iustinG-afk/The48ErrCar/docs/images/1.jpg

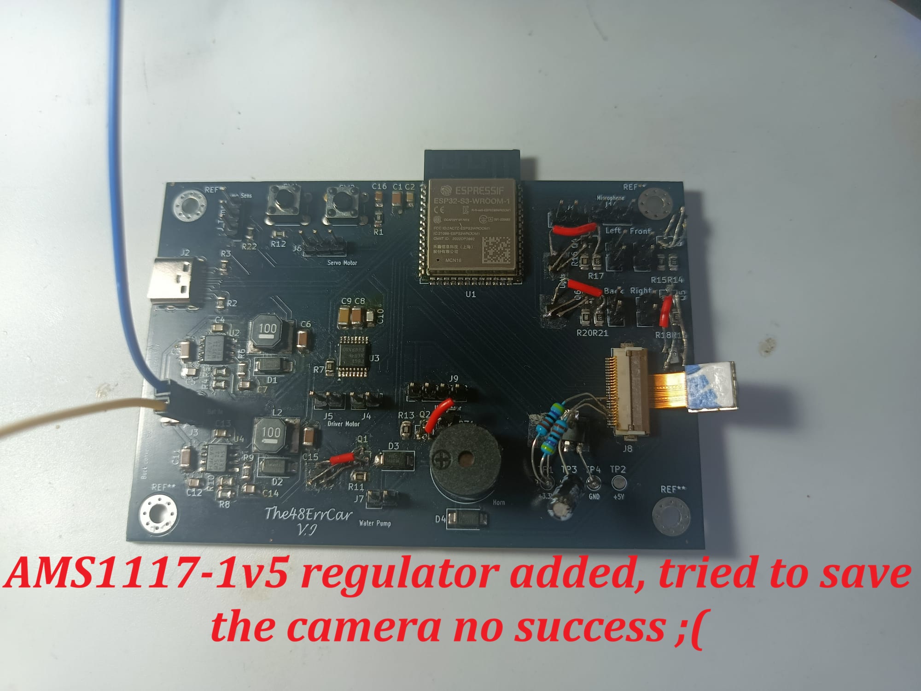
docs/images/1.jpg
