iustinG-afk/The48ErrCar/docs/images/3.jpg

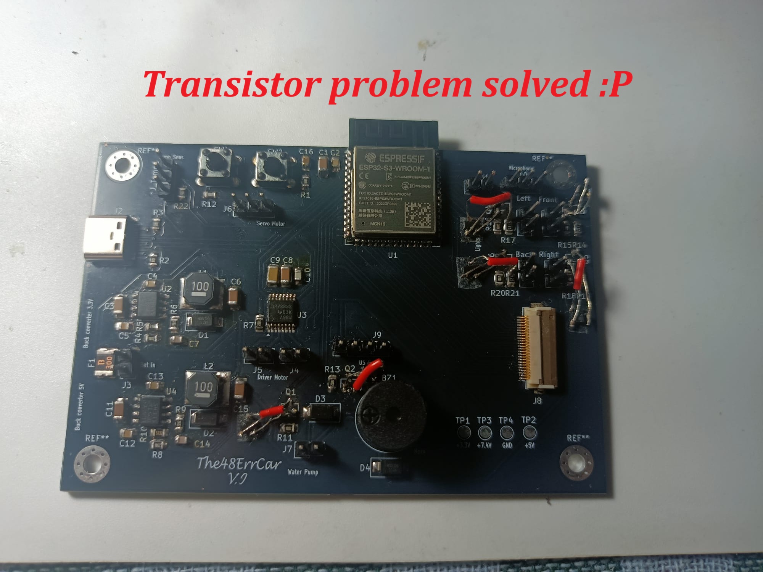
docs/images/3.jpg
