iustinG-afk/The48ErrCar/docs/images/4.jpg

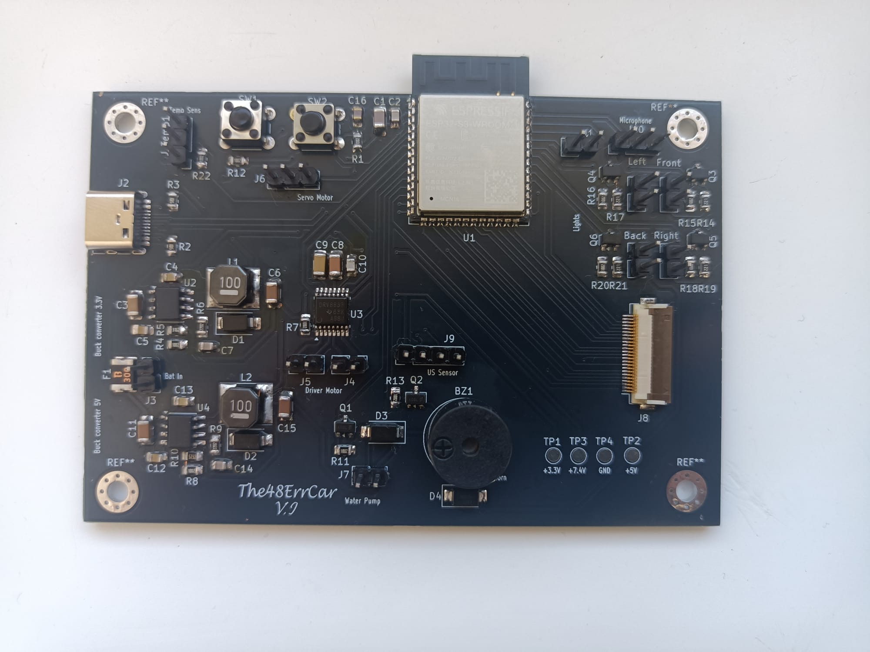
docs/images/4.jpg
