iustinG-afk/The48ErrCar/docs/images/5.jpg

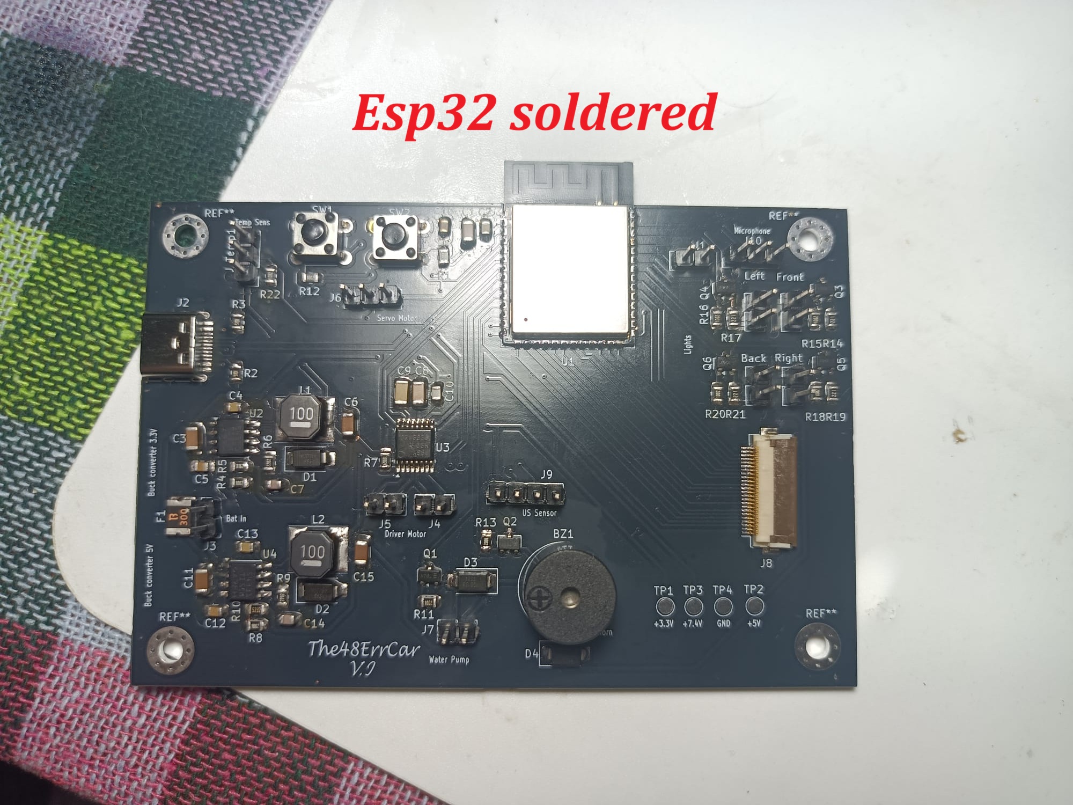
docs/images/5.jpg
