iustinG-afk/The48ErrCar/docs/images/6.jpg

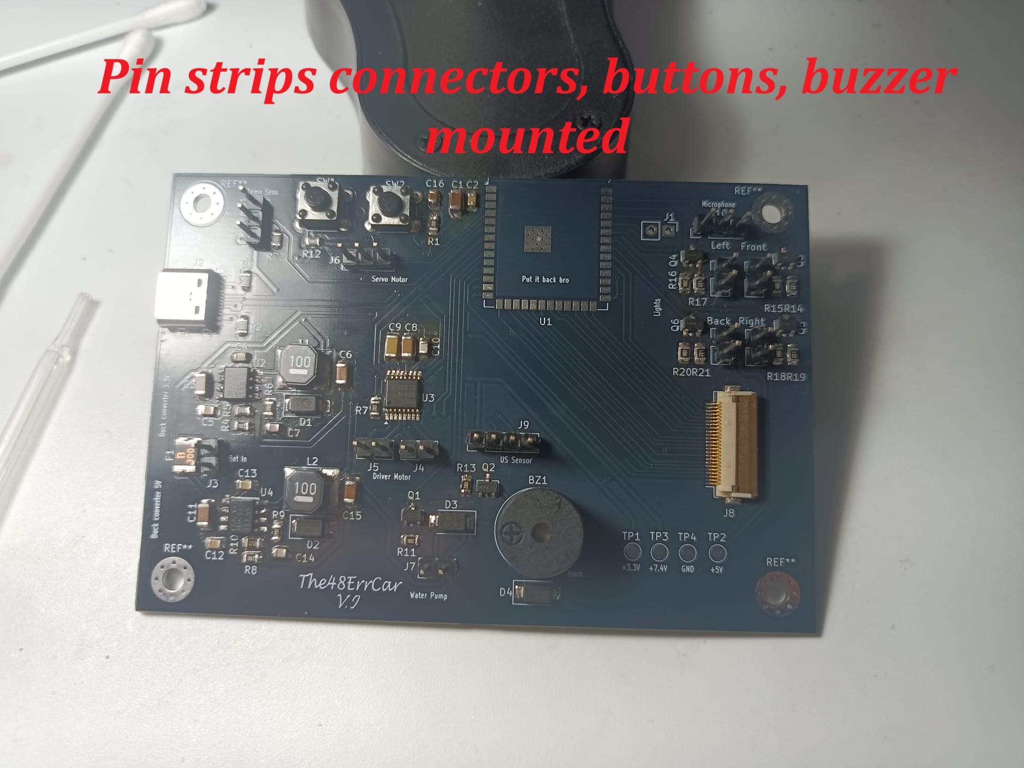
docs/images/6.jpg
