iustinG-afk/The48ErrCar/docs/images/7.jpg

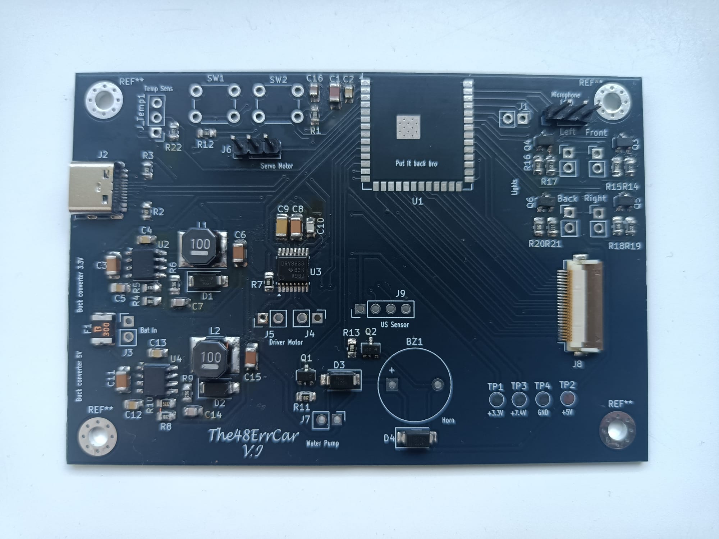
docs/images/7.jpg
