iustinG-afk/The48ErrCar/docs/images/8.jpg

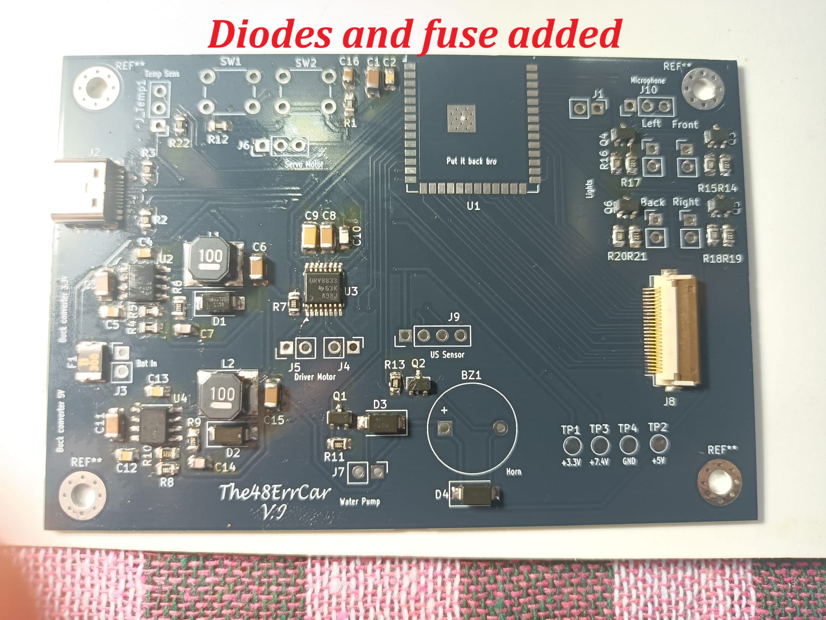
docs/images/8.jpg
