iustinG-afk/The48ErrCar/docs/images/9.jpg

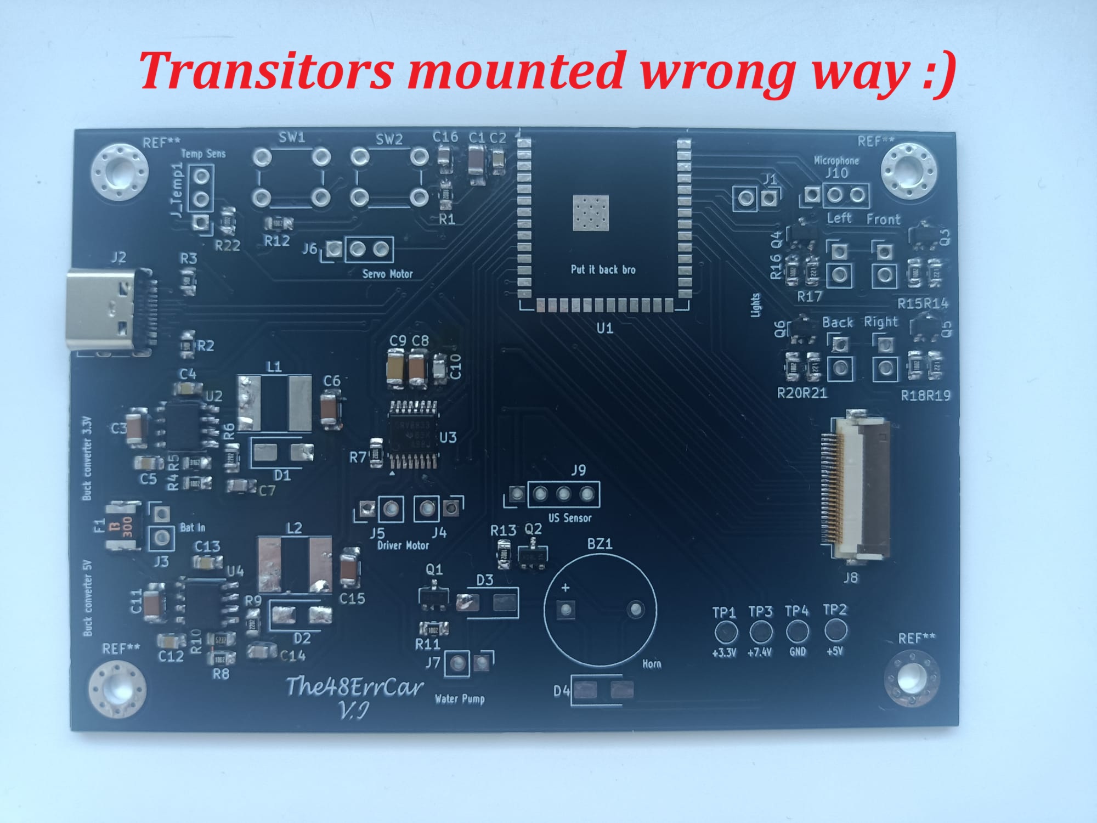
docs/images/9.jpg
