iustinG-afk/The48ErrCar/docs/images/11.jpg

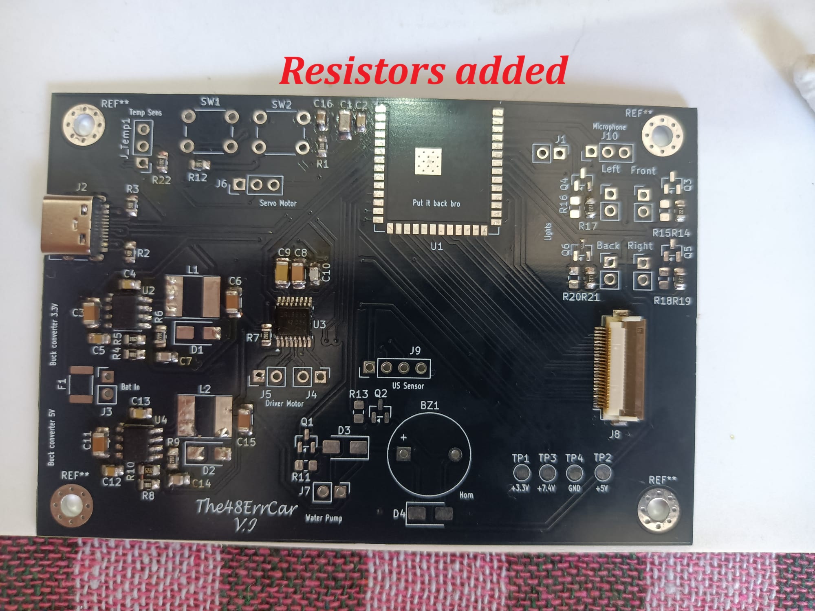
docs/images/11.jpg
