iustinG-afk/The48ErrCar/docs/images/13.jpg

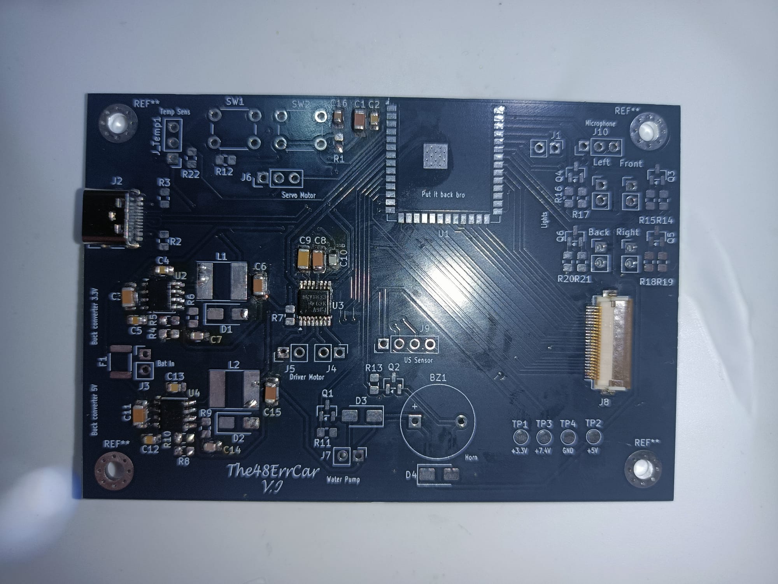
docs/images/13.jpg
