iustinG-afk/The48ErrCar/docs/images/14.jpg

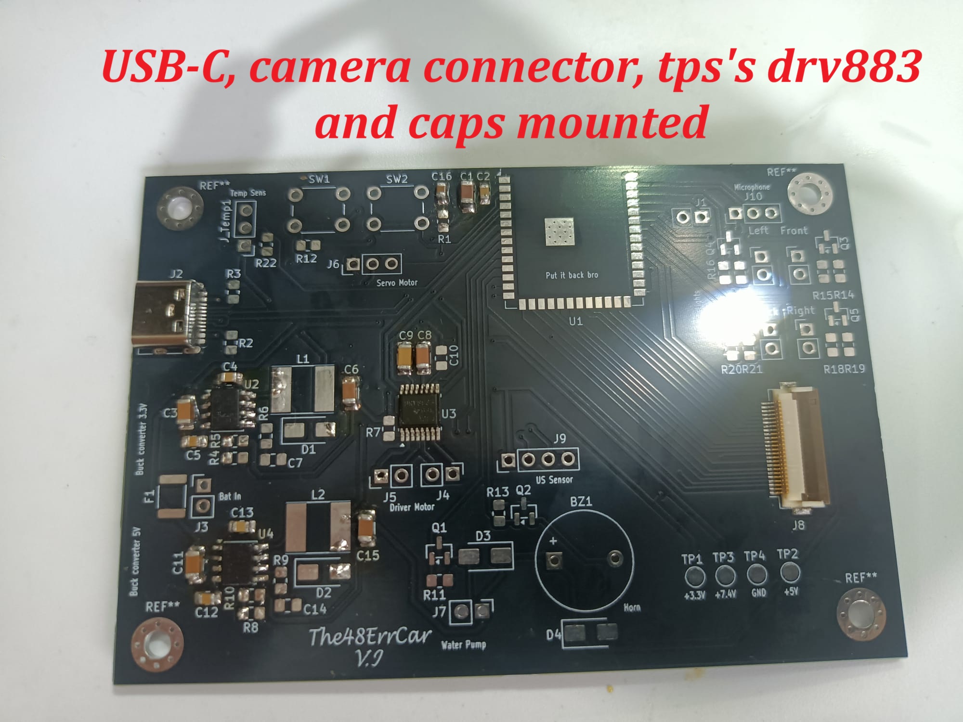
docs/images/14.jpg
