iustinG-afk/The48ErrCar/docs/images/18.jpg

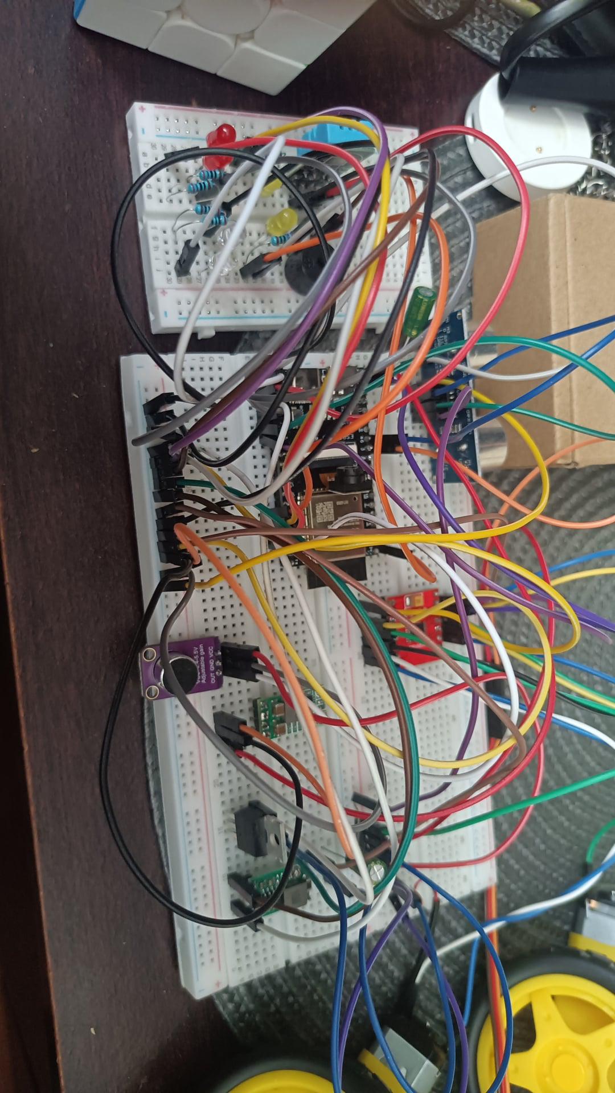
docs/images/18.jpg
