iustinG-afk/The48ErrCar/docs/images/20.jpg

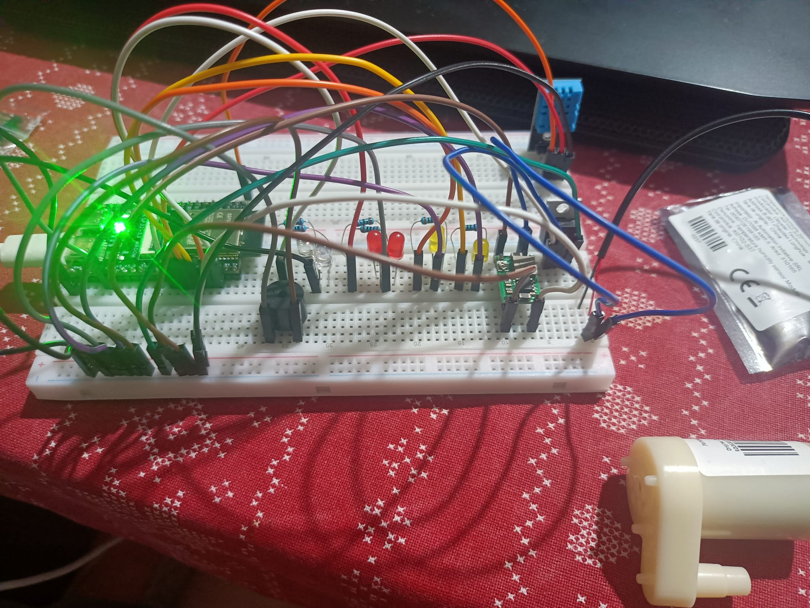
docs/images/20.jpg
