iustinG-afk/The48ErrCar/docs/images/23.jpg

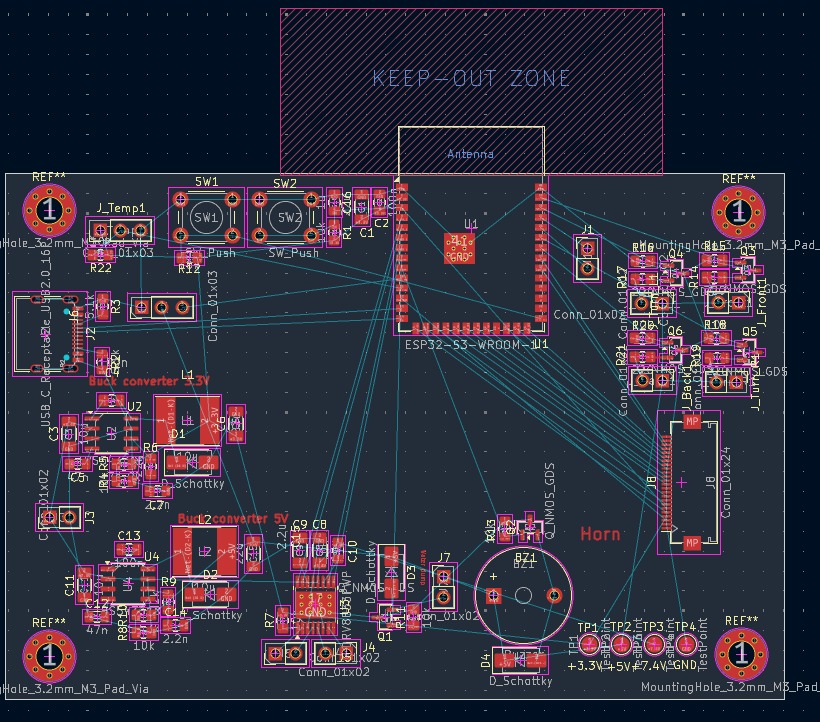
docs/images/23.jpg
