iustinG-afk/The48ErrCar/MIT/screen1.png

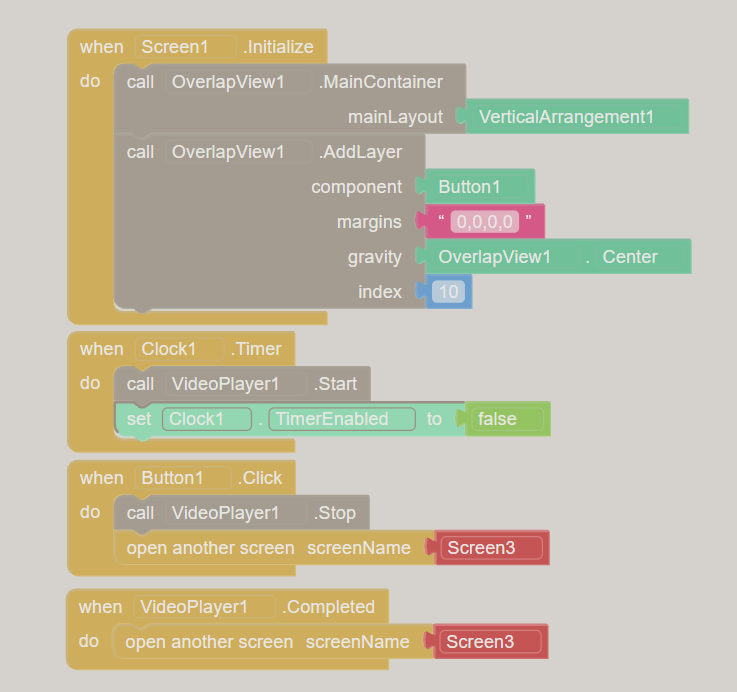
MIT/screen1.png
