iustinG-afk/The48ErrCar/MIT/screen2.png

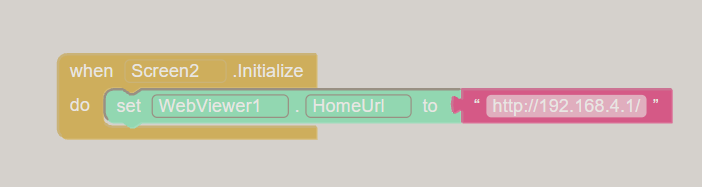
MIT/screen2.png
