iustinG-afk/The48ErrCar/MIT/screen3.png

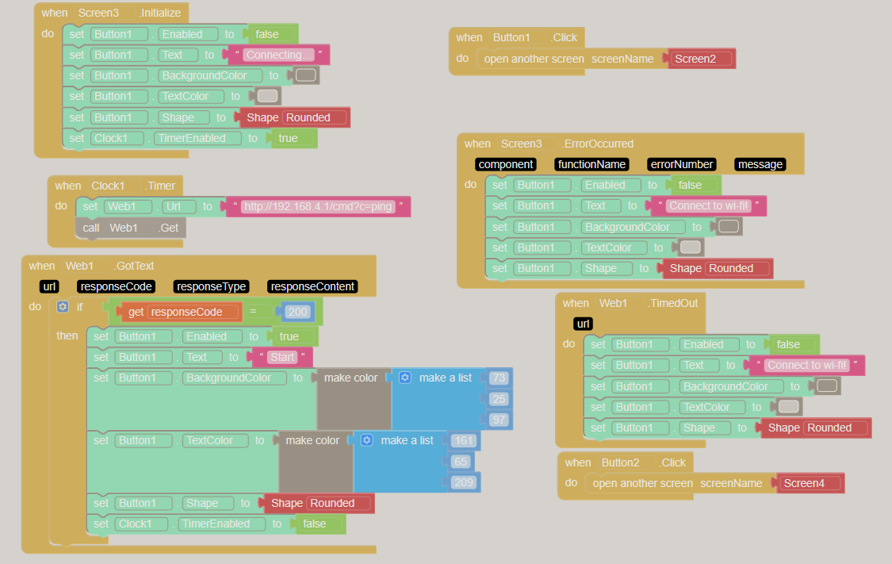
MIT/screen3.png
