iustinG-afk/The48ErrCar/MIT/screen4.png

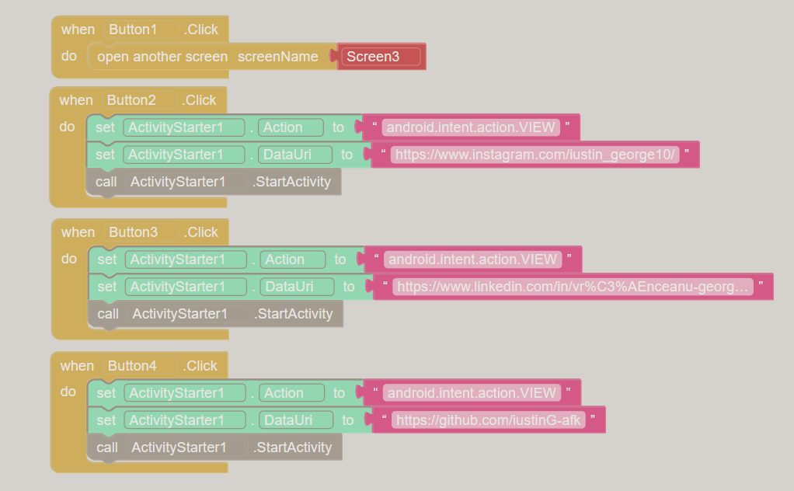
MIT/screen4.png
