iustinG-afk/The48ErrCar/MIT/The48ErrCar.png

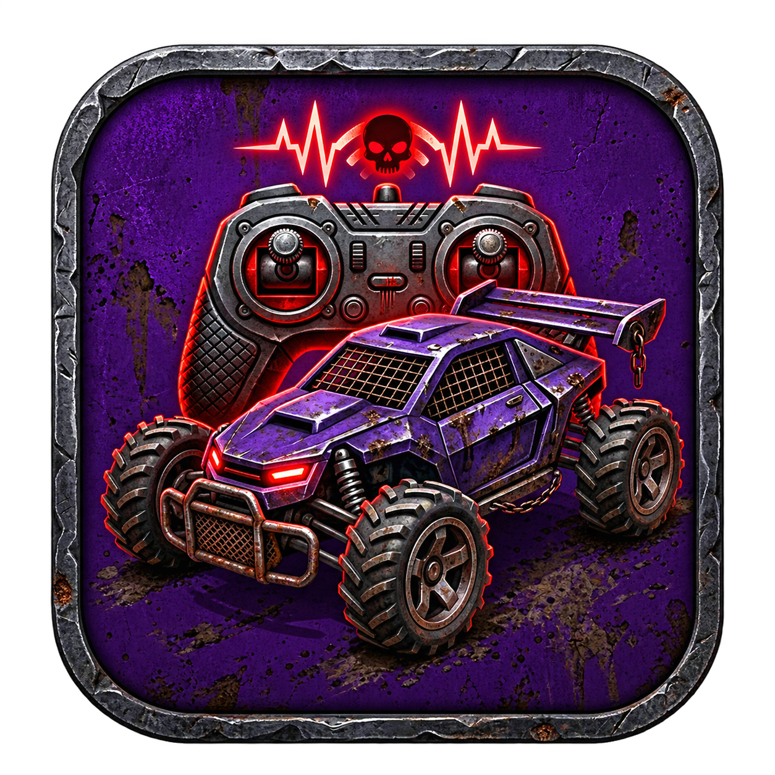
MIT/The48ErrCar.png
