iustinG-afk/The48ErrCar/hardware/The Big One.kicad_pcb

## KiCad design hardware/The Big One.kicad_pcb (2026-10-18)

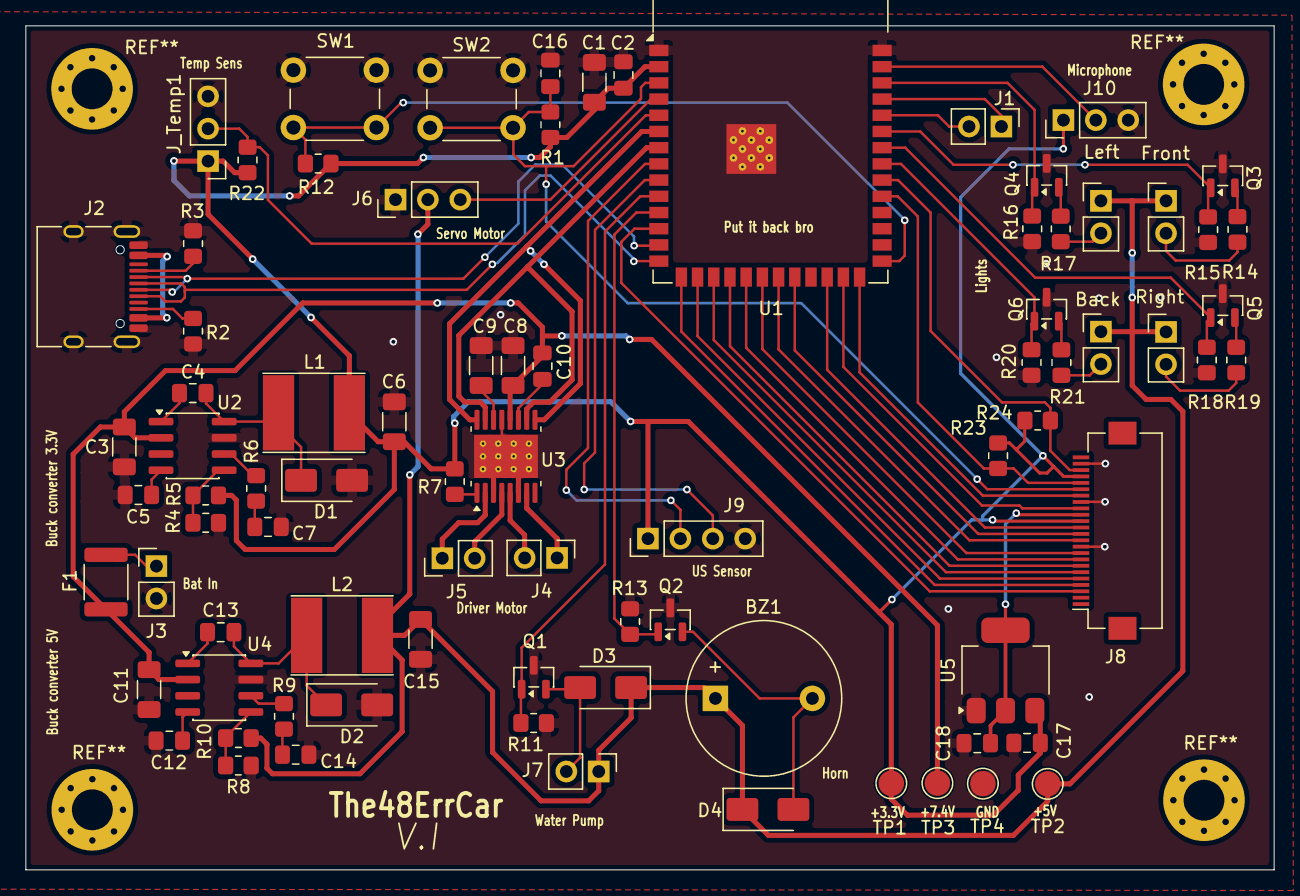
[picture p30: board The Big One.kicad_pcb from above]

Board: 2 copper layers, 97.8 x 66.2 mm, 82 parts (0 on the bottom side), 71 nets.

Parts:
BZ1: Buzzer; Buzzer_12x9.5RM7.6
Back: Conn_01x02; PinHeader_1x02_P2.54mm_Vertical
C1, C6, C15: 22u; C_1206_3216Metric_Pad1.33x1.80mm_HandSolder
C2, C4, C13: 100n; C_0805_2012Metric_Pad1.18x1.45mm_HandSolder
C3, C8, C11: 10u; C_1206_3216Metric_Pad1.33x1.80mm_HandSolder
C5, C12: 47n; C_0805_2012Metric_Pad1.18x1.45mm_HandSolder
C7, C14: 2.2n; C_0805_2012Metric_Pad1.18x1.45mm_HandSolder
C9: 2.2u; C_1206_3216Metric_Pad1.33x1.80mm_HandSolder
C10: 10n; C_0805_2012Metric_Pad1.18x1.45mm_HandSolder
C16: 1u; C_0805_2012Metric_Pad1.18x1.45mm_HandSolder
C17, C18: 10uF; C_0805_2012Metric_Pad1.18x1.45mm_HandSolder
D1, D2, D3, D4: D_Schottky; D_SMA
F1: 3A; Fuse_1812_4532Metric
Front: Conn_01x02; PinHeader_1x02_P2.54mm_Vertical
J1, J3, J4, J5, J7: Conn_01x02; PinHeader_1x02_P2.54mm_Vertical
J2: USB_C_Receptacle_USB2.0_16P; USB_C_Receptacle_HRO_TYPE-C-31-M-12
J6, J10: Conn_01x03; PinHeader_1x03_P2.54mm_Vertical
J8: Conn_01x24; Hirose_FH12-24S-0.5SH_1x24-1MP_P0.50mm_Horizontal
J9: Conn_01x04; PinHeader_1x04_P2.54mm_Vertical
J_Temp1: Conn_01x03; PinHeader_1x03_P2.54mm_Vertical
L1, L2: 10u; L_Taiyo-Yuden_NR-60xx_HandSoldering
Left: Conn_01x02; PinHeader_1x02_P2.54mm_Vertical
Q1, Q2, Q3, Q4, Q5, Q6: Q_NMOS_GDS; SOT-23
R1, R4, R7, R8, R11, R12, R13, R15, R16, R18, R20, R22: 10k; R_0805_2012Metric_Pad1.20x1.40mm_HandSolder
R2, R3: 5.1k; R_0805_2012Metric_Pad1.20x1.40mm_HandSolder
R5: 31.6k; R_0805_2012Metric_Pad1.20x1.40mm_HandSolder
R6, R9: 22k; R_0805_2012Metric_Pad1.20x1.40mm_HandSolder
R10: 52.3k; R_0805_2012Metric_Pad1.20x1.40mm_HandSolder
R14, R17, R19, R21: 220; R_0805_2012Metric_Pad1.20x1.40mm_HandSolder
R23, R24: 4.7k; R_0805_2012Metric_Pad1.20x1.40mm_HandSolder
Right: Conn_01x02; PinHeader_1x02_P2.54mm_Vertical
SW1, SW2: SW_Push; SW_PUSH_6mm_H5mm
TP1, TP2, TP3, TP4: TestPoint; TestPoint_Pad_D2.0mm
U1: ESP32-S3-WROOM-1
U2, U4: TPS54331D; SOIC-8_3.9x4.9mm_P1.27mm
U3: DRV8833PWP; HTSSOP-16-1EP_4.4x5mm_P0.65mm_EP3.4x5mm_Mask2.46x2.31mm_The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
U5: AMS1117-1.5; SOT-223-3_TabPin2

Connections:
+3.3V: C1.2, C2.1, C6.1, C17.1, J8.14, J8.21, J9.1, J10.1, J_Temp1.1, L1.2, R1.2, R5.2, R7.2, R12.2, R22.1, R23.1, R24.1, TP1.1 (1_1), U1.2 (3V3), U5.3 (VI)
+5V: BZ1.1 (+), Back.1, C15.1, D3.1 (K), D4.1 (K), Front.1, J6.2, J7.1, L2.2, Left.1, R10.2, Right.1, TP2.1 (1_1)
+7.4V: C3.2, C8.1, C10.1, C11.2, F1.2, TP3.1 (1_1), U2.2 (VIN), U3.12 (VM), U4.2 (VIN)
/1.5V: C18.1, J8.15, U5.2 (VO)
/+5V_USB: J2.A4 (VBUS), J2.A9 (VBUS), J2.B4 (VBUS), J2.B9 (VBUS)
/Cam_D0: J8.6, U1.17 (IO9)
/Cam_D1: J8.4, U1.15 (IO3)
/Cam_D2: J8.3, U1.12 (IO8)
/Cam_D3: J8.5, U1.16 (IO46)
/Cam_D4: J8.7, U1.18 (IO10)
/Cam_D5: J8.9, U1.20 (IO12)
/Cam_D6: J8.11, U1.21 (IO13)
/Cam_D7: J8.13, U1.24 (IO47)
/Cam_HREF: J8.16, U1.25 (IO48)
/Cam_PCLK: J8.8, U1.19 (IO11)
/Cam_SCL: J8.20, R23.2, U1.31 (IO38)
/Cam_SDA: J8.22, R24.2, U1.32 (IO39)
/Cam_VSYNC: J8.18, U1.26 (IO45)
/Cam_XCLK: J8.12, U1.22 (IO14)
/D+: J2.A6 (D+), J2.B6 (D+), U1.14 (USB_D+)
/D-: J2.A7 (D-), J2.B7 (D-), U1.13 (USB_D-)
/EN: C16.2, J8.19, R1.1, SW2.2, U1.3 (EN)
/Horn_CTRL: Q2.1 (G), R13.2, U1.11 (IO18)
/Light_Back: Q6.1 (G), R20.1, U1.33 (IO40)
/Light_Front: Q3.1 (G), R15.1, U1.35 (IO42)
/Light_Turn_L: Q4.1 (G), R16.1, U1.38 (IO2)
/Light_Turn_R: Q5.1 (G), R18.1, U1.34 (IO41)
/MIC_OUT: J10.2, U1.39 (IO1)
/Motor_FWD: U1.6 (IO6), U3.9 (BIN1), U3.16 (AIN1)
/Motor_REV: U1.7 (IO7), U3.10 (BIN2), U3.15 (AIN2)
/Pump_CTRL: Q1.1 (G), R11.1, U1.10 (IO17)
/Servo_PWM: J6.3, U1.4 (IO4)
/Temp_Data: J_Temp1.2, R22.2, U1.5 (IO5)
/US_ECHO: J9.3, U1.9 (IO16)
/US_TRIG: J9.2, U1.8 (IO15)
/Vs_3.3: R4.1, R5.1, U2.5 (VSENSE)
/Vs_5: R8.1, R10.1, U4.5 (VSENSE)
GND: C1.1, C2.2, C3.1, C5.1, C6.2, C7.2, C8.2, C9.1, C11.1, C12.1, C14.2, C15.2, C16.1, C17.2, C18.2, D1.2 (A), D2.2 (A), J2.A1 (GND), J2.A12 (GND), J2.B1 (GND), J2.B12 (GND), J2.SH (SHIELD), J3.2, J6.1, J8.10, J8.17, J8.23, J9.4, J10.3, J_Temp1.3, Q1.3 (S), Q2.3 (S), Q3.3 (S), Q4.3 (S), Q5.3 (S), Q6.3 (S), R2.1, R3.1, R4.2, R8.2, R11.2, R13.1, R15.2, R16.2, R18.2, R20.2, SW1.1, SW2.1, TP4.1 (1_1), U1.1 (GND), U1.40 (GND), U1.41 (GND), U2.7 (GND), U3.3 (AISEN), U3.6 (BISEN), U3.13 (GND), U3.17 (GND), U4.7 (GND), U5.1 (GND)
unnamed: BZ1.2 (-), D4.2 (A), Q2.2 (D)
unnamed: C7.1, R6.2
unnamed: C14.1, R9.2
unnamed: C4.1, D1.1 (K), L1.1, U2.8 (PH)
unnamed: C13.1, D2.1 (K), L2.1, U4.8 (PH)
unnamed: D3.2 (A), J7.2, Q1.2 (D)
unnamed: J1.1, U1.37 (TXD0)
unnamed: J1.2, U1.36 (RXD0)
unnamed: J2.A5 (CC1), R3.2
unnamed: J2.B5 (CC2), R2.2
unnamed: F1.1, J3.1
unnamed: J4.1, U3.7 (BOUT1)
unnamed: J4.2, U3.5 (BOUT2)
unnamed: J5.1, U3.2 (AOUT1)
unnamed: J5.2, U3.4 (AOUT2)
unnamed: Back.2, R21.1
unnamed: Front.2, R14.1
unnamed: Left.2, R17.1
unnamed: R19.1, Right.2
unnamed: Q3.2 (D), R14.2
unnamed: Q4.2 (D), R17.2
unnamed: Q5.2 (D), R19.2
unnamed: Q6.2 (D), R21.2
unnamed: R12.1, SW1.2, U1.27 (IO0)
unnamed: C4.2, U2.1 (BOOT)
unnamed: R6.1, U2.6 (COMP)
unnamed: C5.2, U2.4 (SS)
unnamed: C10.2, U3.11 (VCP)
unnamed: C9.2, U3.14 (VINT)
unnamed: R7.1, U3.1 (~SLEEP)
unnamed: C13.2, U4.1 (BOOT)
unnamed: R9.1, U4.6 (COMP)
unnamed: C12.2, U4.4 (SS)
