iustinG-afk/The48ErrCar/(commit log)

2026-10-18 hardware
    .kicad_pro, .kicad_sch, .kicad_pcb & gerber files
    [The Big One.kicad_pcb, The Big One.kicad_sch]
2026-10-18 Add files via upload
    .kicad_pro / .kicad_sch / .kicad_pcb & gerber files
    [The Big One.kicad_pcb, The Big One.kicad_sch]
2026-10-19 Add files via upload
    esp32 code
2026-10-19 Add files via upload
    through-hole version
